EmaMaker/SignalGenerator-Teensy/Docs/Images/IMG_20210525_190113337.jpg

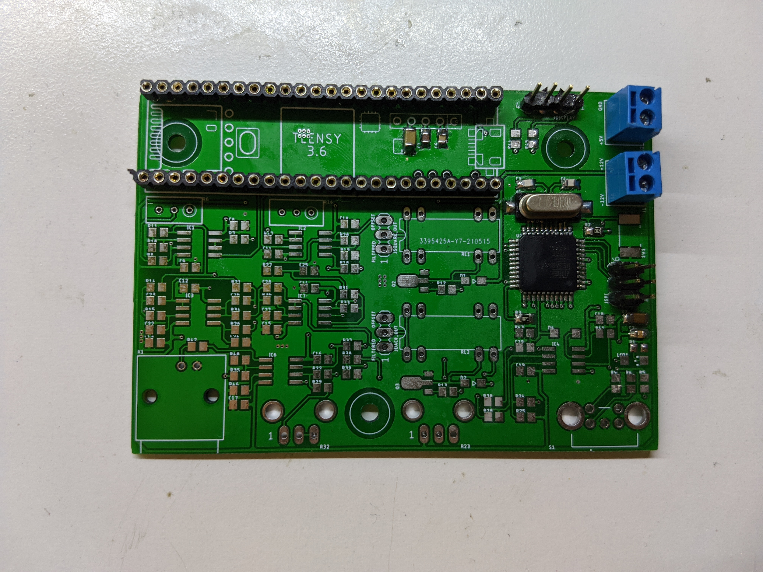
Docs/Images/IMG_20210525_190113337.jpg
