EmaMaker/SignalGenerator-Teensy/Docs/Images/IMG_20210525_205714208.jpg

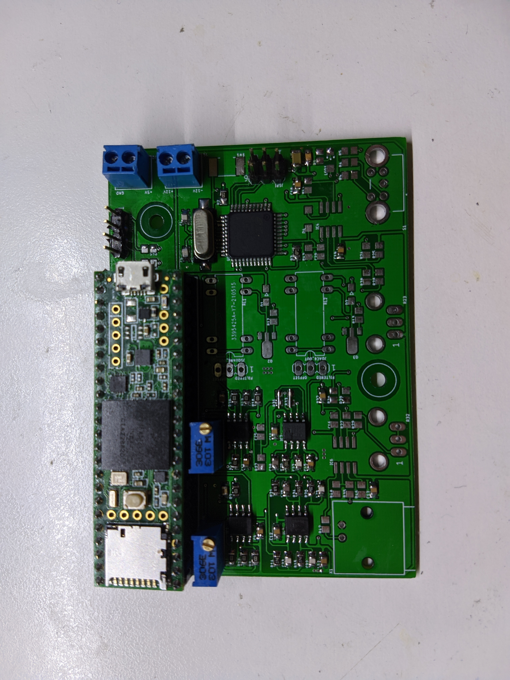
Docs/Images/IMG_20210525_205714208.jpg
