EmaMaker/SignalGenerator-Teensy/Docs/Images/IMG_20210525_221929318.jpg

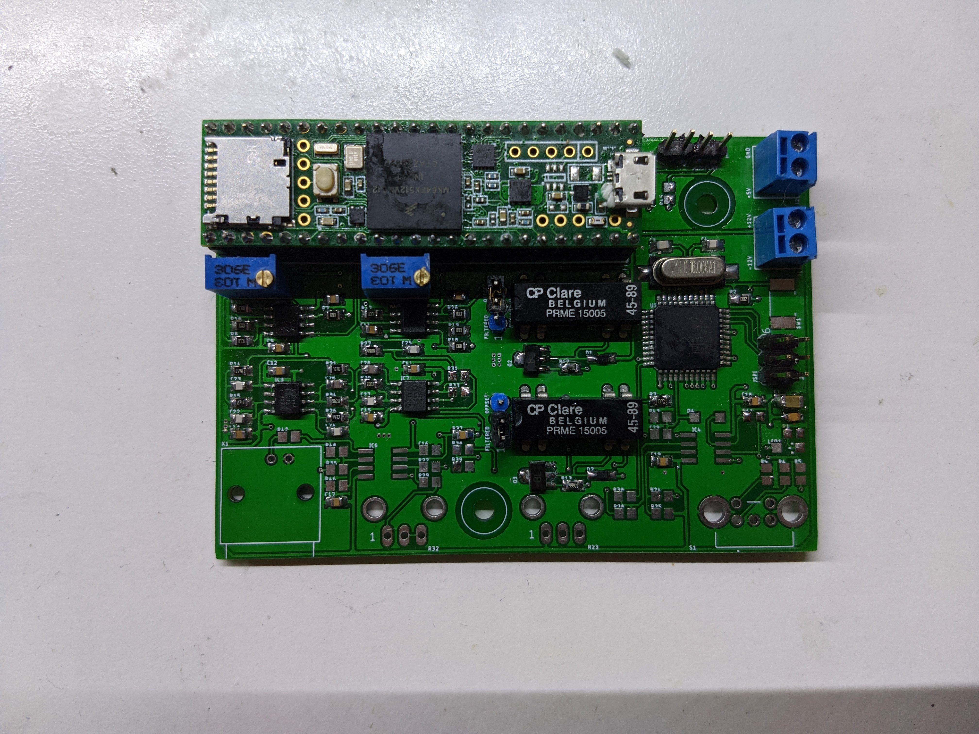
Docs/Images/IMG_20210525_221929318.jpg
