EmaMaker/SignalGenerator-Teensy/Docs/Images_Edit/IMG_20210525_210142045.jpg

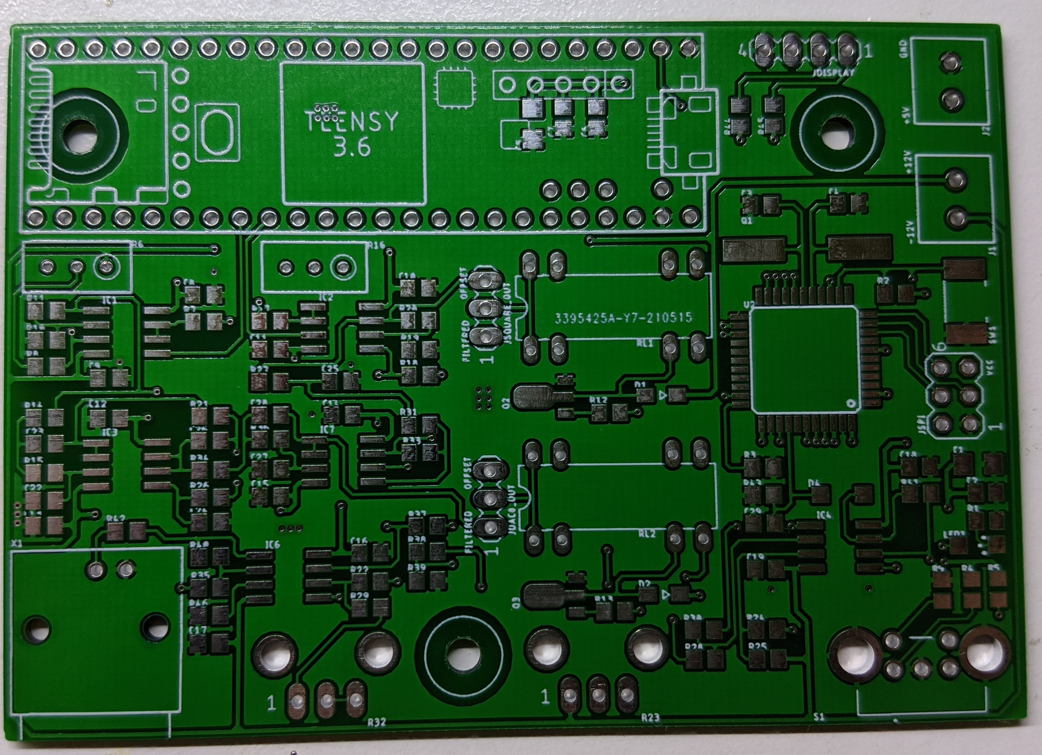
Docs/Images_Edit/IMG_20210525_210142045.jpg
