EmaMaker/SignalGenerator-Teensy/Hardware/BoM.ods

Name of component | Quantity | TME code | Link | Additional notes | Cost per unit € | Total cost €
Teensy 3.5 | 1 | / | https://www.pjrc.com/store/teensy35.html |  | 21 | 21
PCB Connectors | 2 | 1776275-2 | https://www.tme.eu/it/details/1776275-2/morsettiere-per-montaggio-su-scheda/te-connectivity/ |  | 0,38 | 0,76
AD8034ARZ OpAmp | 7 | AD8034ARZ | https://www.tme.eu/it/details/ad8034arz/amplificatori-operazionali-smd/analog-devices/ |  | 3,64 | 25,48
Incremental Encoder | 1 | EC11B15242 | https://www.tme.eu/it/details/ec11b15242/encoder-incrementali/alps/ |  | 3,97 | 3,97
AtMega 32U4 | 1 |  |  | Already at home | 3,42 | 3,42
Trimmer 10k | 2 | T910W-10K | https://www.tme.eu/it/details/t910w-10k/potenziometri-tht-multi-giri-3-8-pollice/sr-passives/ | Already at home | 0,22 | 0,44
Potentiometers 10k | 2 | / | / | Already at home | 0 | 0
Transistor BJT | 2 | 2DD2652-7 | https://www.tme.eu/it/details/2dd2652-7/transistori-npn-smd/diodes-incorporated/ |  | 0,07 | 0,14
BNC Connectors | 1 | BNC-206 | https://www.tme.eu/it/details/bnc-206/connettori-bnc/ |  | 1,01 | 1,01
PRME15005 | 2 | / | / | Already at home | 0 | 0
16MHz Xtal | 1 | 16.00M-SMDHC49S | https://www.tme.eu/it/details/16.00m-smdhc49s/risonatori-al-quarzo-smd/yic/ |  | 0,35 | 0,35
0805 Resistor kit (E96) | 1 | https://www.amazon.com/Resistor-Ltvystore-Fixed-Assortment-0-125W/dp/B07G4XL65P |  | Not every resistor in the kit is needed | 7 | 7
0805 Resistor kit (E24) | 1 | https://www.amazon.com/Capacitor-Assortment-values-20pcs-component/dp/B008M6PO9G |  | Not every capacitor in the kit is needed | 15 | 15
 |  |  |  |  |  | 0
 |  |  |  |  |  | 0
 |  |  |  |  |  | 0
 |  |  |  |  |  | 0
 |  |  |  |  |  | 78,57
