EmaMaker/SignalGenerator-Teensy/Hardware/teensy3.5dds.brd

## EAGLE design Hardware/teensy3.5dds.brd (2021-05-16)

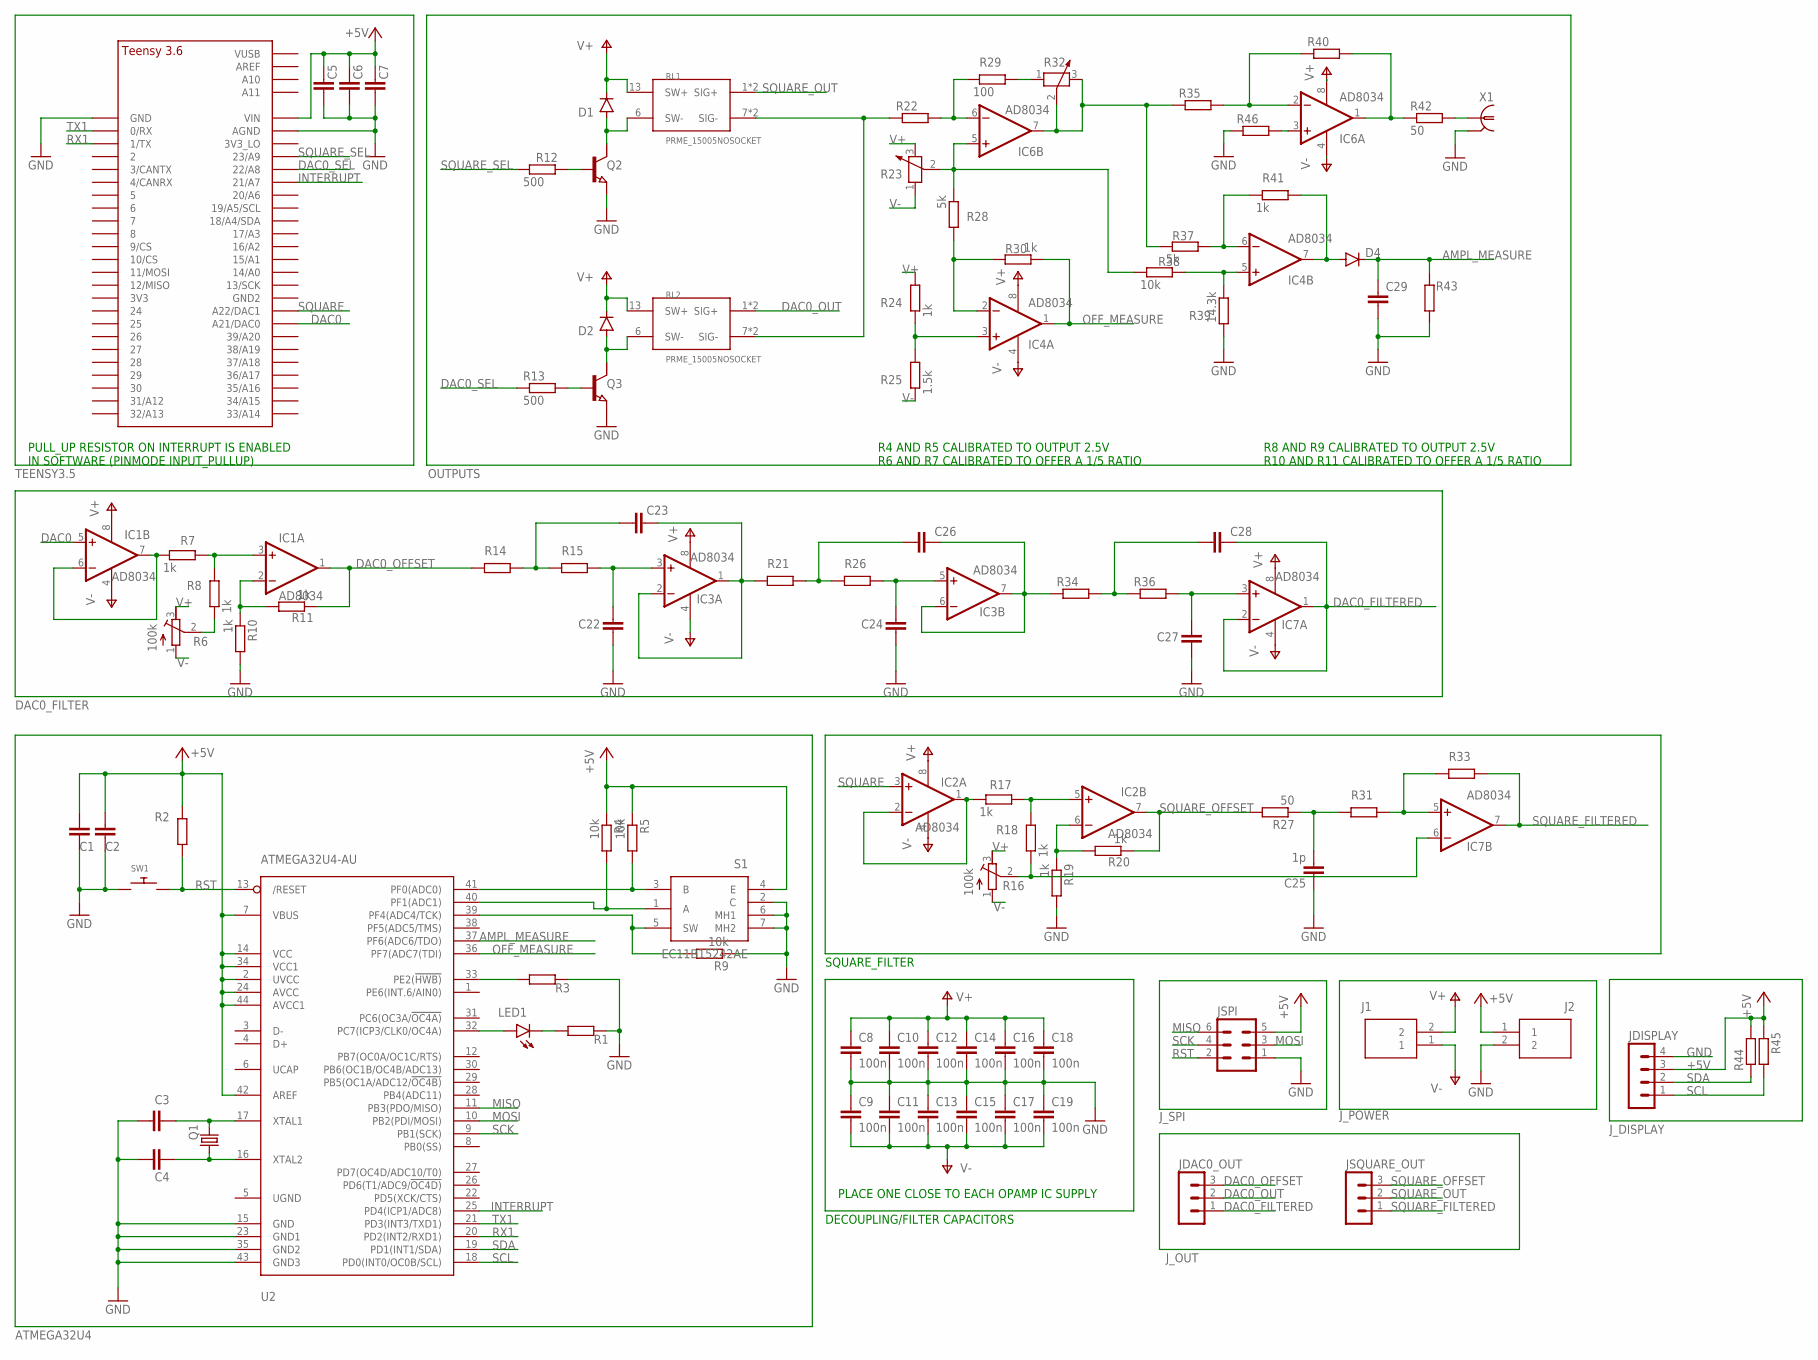
[picture p15: schematic teensy3.5dds.sch]

Parts:
C1, C5: 100u; C1206
C2, C6, C7, C8, C9, C10, C11, C12, C13, C14, C15, C16, C17, C18, C19: 100n; C0805
C3, C4: 22p; C0805
C22, C24, C27: 10p; C0805
C23: 150p; C0805
C25: 1p; C0805
C26, C28: 100p; C0805
C29: C-EUC0805; C0805
D1, D2: DIODE-SOD323-W; SOD323-W
D4: DIODE-SOD123; SOD123
IC1, IC2, IC3, IC4, IC6, IC7: AD8034; SO08
J1, J2: 1776275-2; 17762752
JDAC0_OUT: MA03-1
JDISPLAY: MA04-1
JSPI: MA03-2
JSQUARE_OUT: MA03-1
LED1: LEDCHIPLED_1206; CHIPLED_1206
Q1: 16MHz; CSM-7X-DU
Q2, Q3: NPN-TRANSISTIOR-2COLSOT89; SOT89
R1: 220; R0805
R2, R4, R5, R9, R33, R38: 10k; R0805
R3: 10k; M0805
R6, R16: 100k; RTRIM3296W
R7, R8, R10, R11, R17, R18, R19, R20, R22, R24, R30, R41: 1k; R0805
R12, R13: 500; R0805
R14, R15: 2.74k; R0805
R21: 787; R0805
R23, R32: 10k; MA03-1
R25: 1.5k; R0805
R26, R39: 14.3k; R0805
R27, R42: 50; R0805
R28, R37: 5k; R0805
R29: 100; R0805
R31: 2k; R0805
R34: 562; R0805
R35, R40, R43, R44, R45, R46: R-EU_R0805; R0805
R36: 20k; R0805
RL1, RL2: PRME_15005NOSOCKET; DIL14
S1: EC11B15242AE
SW1: SWITCH_PUSHBUTTONC&K_KSS; BTN_CK_KSS
U1: TEENSY_3.5/3.6_BASIC
U2: ATMEGA32U4-AU; TQFP44
X1: 1-227161-0; AMP_227161

Connections:
+5V: C1.1, C2.1, C5.1, C6.1, C7.1, J2.1, JDISPLAY.3, JSPI.5, R2.2, R4.1, R5.1, R44.2, R45.1, S1.4 (E), U1.VIN, U2.2 (UVCC), U2.7 (VBUS), U2.14 (VCC), U2.24 (AVCC), U2.34 (VCC1), U2.42 (AREF), U2.44 (AVCC1)
AMPL_MEASURE: C29.1, D4.C, R43.2, U2.37 (PF6(ADC6/TDO))
DAC0: IC1.5 (+IN), U1.21/DAC0 (A21/DAC0)
DAC0_FILTERED: C28.1, IC7.1 (OUT), IC7.2 (-IN), JDAC0_OUT.1
DAC0_OFFSET: IC1.1 (OUT), JDAC0_OUT.3, R11.1, R14.1
DAC0_OUT: JDAC0_OUT.2, RL2.1 (SIG+), RL2.14 (SIG+)
DAC0_SEL: R13.1, U1.22/A8
GND: C1.2, C2.2, C3.1, C4.1, C5.2, C6.2, C7.2, C8.2, C9.1, C10.2, C11.1, C12.2, C13.1, C14.2, C15.1, C16.2, C17.1, C18.2, C19.1, C22.1, C24.1, C25.1, C27.1, C29.2, J2.2, JDISPLAY.4, JSPI.1, Q2.3 (E), Q3.3 (E), R1.1, R3.2, R9.1, R10.2, R19.2, R39.2, R43.1, R46.1, S1.2 (C), S1.6 (MH1), S1.7 (MH2), SW1.P$1, U1.AGND, U1.GND, U2.15 (GND), U2.23 (GND1), U2.35 (GND2), U2.43 (GND3), X1.2
INTERRUPT: U1.21/A7, U2.25 (PD4(ICP1/ADC8))
MISO: JSPI.6, U2.11 (PB3(PDO/MISO))
MOSI: JSPI.3, U2.10 (PB2(PDI/MOSI))
unnamed: IC7.5 (+IN), R31.2, R33.1
unnamed: D1.A, Q2.2 (C), RL1.6 (SW-)
unnamed: IC6.5 (+IN), R23.2 (3), R28.1, R38.1
unnamed: C4.2, Q1.1, U2.16 (XTAL2)
unnamed: IC6.6 (-IN), R22.2, R29.1
unnamed: R42.2, X1.1
unnamed: R5.2, S1.3 (B), U2.41 (PF0(ADC0))
unnamed: IC6.7 (OUT), R32.2 (3), R32.3 (2), R35.1, R37.1
unnamed: R22.1, RL1.7 (SIG-), RL1.8 (SIG-), RL2.7 (SIG-), RL2.8 (SIG-)
unnamed: IC4.2 (-IN), R28.2, R30.2
unnamed: D2.A, Q3.2 (C), RL2.6 (SW-)
unnamed: IC4.3 (+IN), R24.1, R25.2
unnamed: IC4.5 (+IN), R38.2, R39.1
unnamed: R29.2, R32.1
unnamed: IC4.6 (-IN), R37.2, R41.1
unnamed: Q2.1 (B), R12.2
unnamed: Q3.1 (B), R13.2
unnamed: IC6.1 (OUT), R40.2, R42.1
unnamed: D4.A, IC4.7 (OUT), R41.2
unnamed: IC1.2 (-IN), R10.1, R11.2
unnamed: IC6.3 (+IN), R46.2
unnamed: IC1.6 (-IN), IC1.7 (OUT), R7.1
unnamed: IC2.6 (-IN), R19.1, R20.2
unnamed: R4.2, S1.1 (A), U2.40 (PF1(ADC1))
unnamed: IC1.3 (+IN), R7.2, R8.2
unnamed: IC2.1 (OUT), IC2.2 (-IN), R17.1
unnamed: IC2.5 (+IN), R17.2, R18.2
unnamed: R9.2, S1.5 (SW), U2.39 (PF4(ADC4/TCK))
unnamed: LED1.A, U2.32 (PC7(ICP3/CLK0/OC4A))
unnamed: C3.2, Q1.2, U2.17 (XTAL1)
unnamed: R3.1, U2.33 (PE2(!HWB))
unnamed: C25.2, R27.1, R31.1
unnamed: IC6.2 (-IN), R35.2, R40.1
unnamed: IC7.6 (-IN), R16.2 (S), R18.1
unnamed: LED1.C, R1.2
unnamed: C23.2, R14.2, R15.1
unnamed: C23.1, IC3.1 (OUT), IC3.2 (-IN), R21.1
unnamed: R6.2 (S), R8.1
unnamed: C22.2, IC3.3 (+IN), R15.2
unnamed: C26.1, R21.2, R26.1
unnamed: C26.2, IC3.6 (-IN), IC3.7 (OUT), R34.1
unnamed: C24.2, IC3.5 (+IN), R26.2
unnamed: C28.2, R34.2, R36.1
unnamed: C27.2, IC7.3 (+IN), R36.2
OFF_MEASURE: IC4.1 (OUT), R30.1, U2.36 (PF7(ADC7(TDI))
RST: JSPI.2, R2.1, SW1.P$2, U2.13 (/RESET)
RX1: U1.1/TX, U2.20 (PD2(INT2/RXD1))
SCK: JSPI.4, U2.9 (PB1(SCK))
SCL: JDISPLAY.1, R45.2, U2.18 (PD0(INT0/OC0B/SCL))
SDA: JDISPLAY.2, R44.1, U2.19 (PD1(INT1/SDA))
SQUARE: IC2.3 (+IN), U1.A22/DAC1
SQUARE_FILTERED: IC7.7 (OUT), JSQUARE_OUT.1, R33.2
SQUARE_OFFSET: IC2.7 (OUT), JSQUARE_OUT.3, R20.1, R27.2
SQUARE_OUT: JSQUARE_OUT.2, RL1.1 (SIG+), RL1.14 (SIG+)
SQUARE_SEL: R12.1, U1.23/A9
TX1: U1.0/RX, U2.21 (PD3(INT3/TXD1))
V+: C8.1, C10.1, C12.1, C14.1, C16.1, C18.1, D1.C, D2.C, IC1.8 (V+), IC2.8 (V+), IC3.8 (V+), IC4.8 (V+), IC6.8 (V+), IC7.8 (V+), J1.2, R6.3 (E), R16.3 (E), R23.3 (2), R24.2, RL1.13 (SW+), RL2.13 (SW+)
V-: C9.2, C11.2, C13.2, C15.2, C17.2, C19.2, IC1.4 (V-), IC2.4 (V-), IC3.4 (V-), IC4.4 (V-), IC6.4 (V-), IC7.4 (V-), J1.1, R6.1 (A), R16.1 (A), R23.1, R25.1

Notes on the sheet:
DECOUPLING/FILTER CAPACITORS
PLACE ONE CLOSE TO EACH OPAMP IC SUPPLY
R4 AND R5 CALIBRATED TO OUTPUT 2.5V R6 AND R7 CALIBRATED TO OFFER A 1/5 RATIO
R8 AND R9 CALIBRATED TO OUTPUT 2.5V R10 AND R11 CALIBRATED TO OFFER A 1/5 RATIO
PULL_UP RESISTOR ON INTERRUPT IS ENABLED IN SOFTWARE (PINMODE INPUT_PULLUP)
SQUARE_FILTER

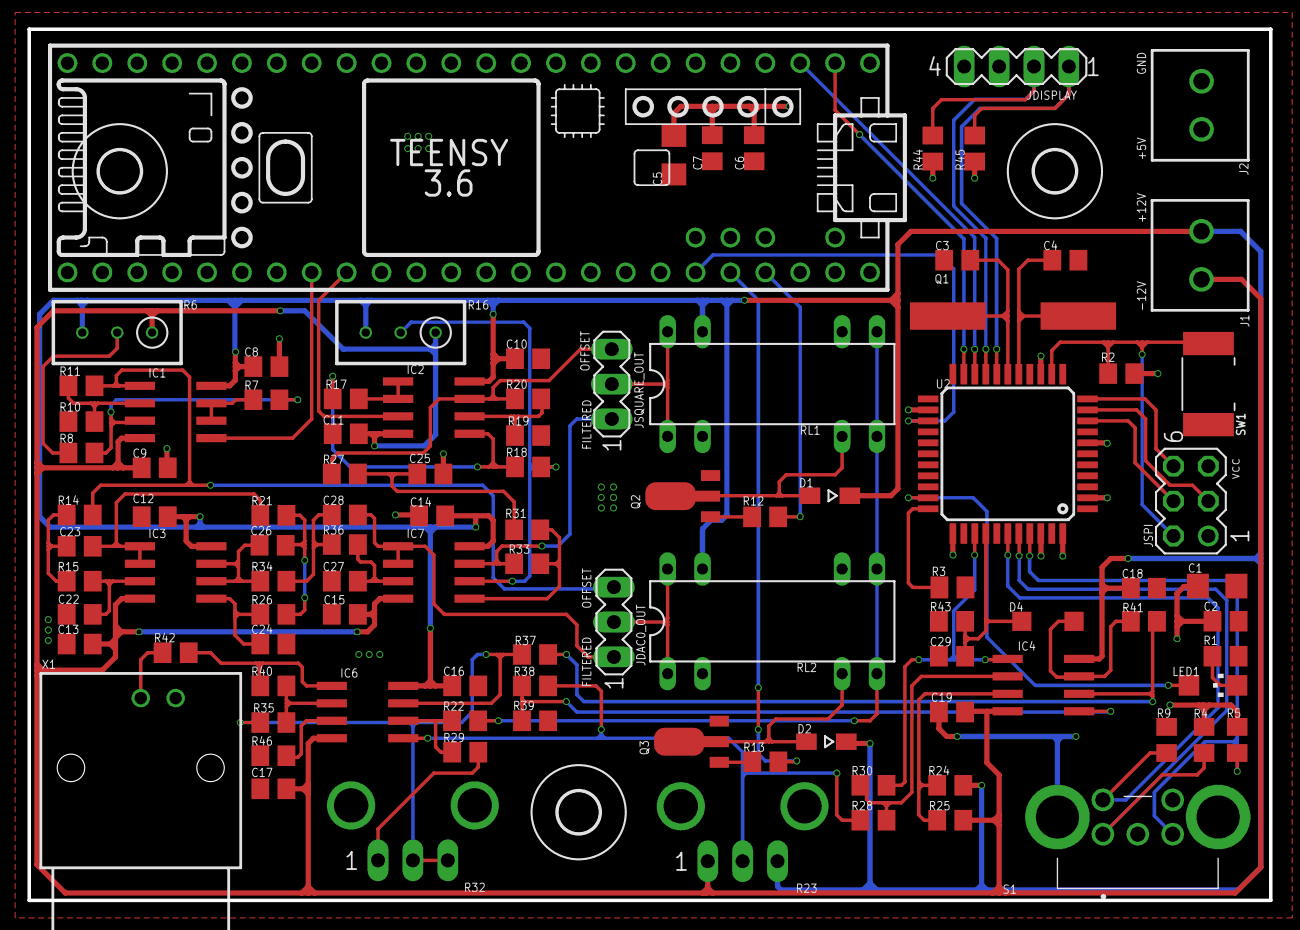
[picture p16: board teensy3.5dds.brd from above]

Board: 2 copper layers, 90.4 x 63.4 mm, 102 parts (0 on the bottom side), 69 nets.

Other parts of the board:
U$1, U$3, U$4: 3,0
