EmaMaker/SignalGenerator-Teensy/(commit log)

2021-02-13 optimize DAC using calling registers instead of analogWriteDAC0
    Take what's needed from framework's analogWriteDAC0
    A sine wave of 1MHz can now be generate without any problem
    [main.cpp, wave.h]
2021-03-07 hardware: Schematic v0.1 Still missing values for passive components Incomplete BoM Some trimmers need to be changed to vertically-positioned potentiometers
    [BoM.ods, teensy3.5dds.brd, teensy3.5dds.sch]
2021-03-07 hardware: better output select circuit And start arranging the components on the board
    [BoM.ods, teensy3.5dds.brd, teensy3.5dds.sch]
2021-03-09 hardware: switch to electronic opamp symbol * Add decoupling caps for each opamp IC * Change place to peak detector circuit, although the whole circuit needs to be changed
    [teensy3.5dds.brd, teensy3.5dds.sch]
2021-03-09 hardware: add interrupt pin between 32u4 and teensy
    [teensy3.5dds.brd, teensy3.5dds.sch]
2021-03-10 Revert "add support for dual channel sine waves"
    This reverts commit f3b1f87aa756bbdf2d2a4fc2abd1415255ae98b2.
    [main.cpp]
2021-03-10 hardware: better relay switching circuit
    [teensy3.5dds.brd, teensy3.5dds.sch]
2021-03-11 hardware: switch to AD737 instead of peak detector circuit Peak detector needed external impedance decoupling and would not have worked when the offset was different from 0 or when the amplification 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
    [teensy3.5dds.brd, teensy3.5dds.sch]
2021-03-12 hardware: change some trimmers and potentiometers
    [teensy3.5dds.sch]
2021-03-12 hardware: start arranging components on the board
    [teensy3.5dds.brd]
2021-03-12 Schematic v0.2
2021-03-17 hardware: board v0.1
    [teensy3.5dds.brd, teensy3.5dds.sch]
2021-03-18 hardware: board v0.2 shrink by 1cm on one side
    [teensy3.5dds.brd]
2021-03-19 hardware: board v0.3 could it by shrinked a little bit on the shorter side?
    [teensy3.5dds.brd, teensy3.5dds.sch]
2021-03-19 hardware: board v0.4 add M4 mounting holes
    [teensy3.5dds.brd]
2021-03-19 hardware: add 50 Ohm resistor before BNC connector
    [teensy3.5dds.brd, teensy3.5dds.sch]
2021-03-19 hardware: board v0.5 * shrink down to 11*8.5cm * Correct a few derps * Cumulative of caps changes on teensy and 32u4, add writes to output type choosing * Ignore overlap on transistors * Ignore AirWi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
    [teensy3.5dds.brd]
2021-03-20 hardware: renumber parts * Label power connector on board
    [teensy3.5dds.brd, teensy3.5dds.sch]
2021-03-28 little fixes
    [BoM.ods, teensy3.5dds.brd, teensy3.5dds.sch]
2021-03-28 an actually working filter for the square wave
    [teensy3.5dds.brd, teensy3.5dds.sch]
2021-03-29 board redisegn
    [teensy3.5dds.brd, teensy3.5dds.sch]
2021-04-02 fixes following the advice of people better than me at making PCBs
    [teensy3.5dds.brd, teensy3.5dds.sch]
2021-04-12 board v1.0
    [teensy3.5dds.brd, teensy3.5dds.csv, teensy3.5dds.sch]
2021-05-02 firmware: recalculate SAMPLE_FREQ for accurate frequency output
2021-05-16 hardware: board v2.0
    correct a few derps with missing resistors
    correct encoder pushbutton
    add i2c pullup resistors
    move some 32u4 pins to more accessible ones, supported by the arduino micro bootloader
    wire the 5v led to the builtin led on 32u4
    remove the ad737, move the a non-inverting summer circuit (wave+offset) with a peak finder to get the peak of the wave no matter the offset condition
    [BoM.ods, teensy3.5dds.brd, teensy3.5dds.csv, teensy3.5dds.sch, teensy3.5dds_old.csv]
2021-05-16 firmware: add communication between 32u4 and teensy
2021-05-27 hardware: beautify schematic, add values
2021-05-27 hardware: beautify schematic and add values
    [BoM.ods, teensy3.5dds.csv, teensy3.5dds.sch, teensy3.5dds_old.csv]
2021-05-27 firmware: overclock teensy
2021-05-29 firmware: always empty buffers when reading And recalculate SAMPLE_FREQ
2021-06-14 firmware-32u4: add reading of offset and peak voltages
2021-06-14 firmware-teensy: default to none of the outputs selected
2021-06-17 firmware-32u4: just a couple more fixed before the exam
    [gdf_32u4.ino]
